ringedSquid/StuyOly_DB_2022/media/V2.jpg

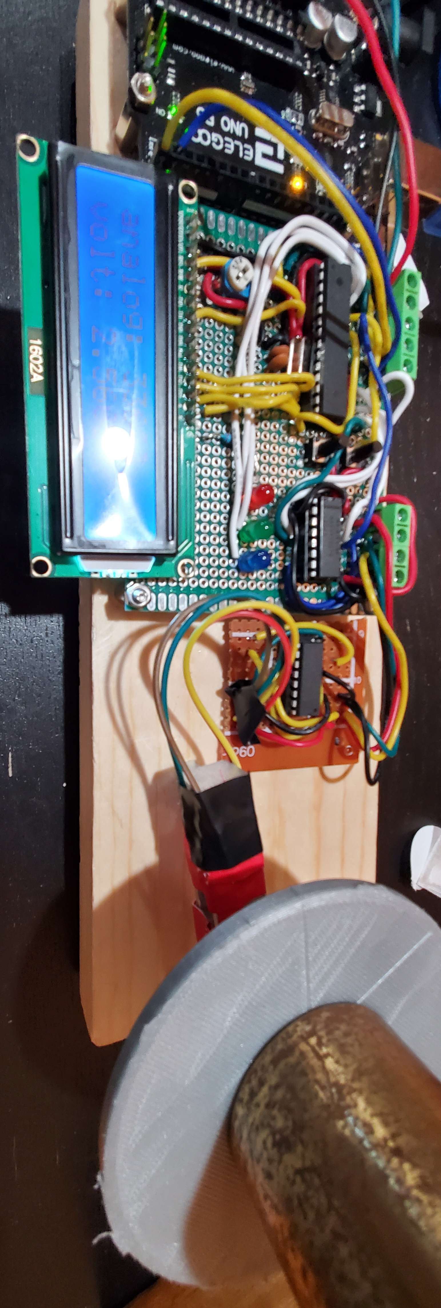
media/V2.jpg
