ringedSquid/StuyOly_DB_2022/media/V2_Gauge.jpg

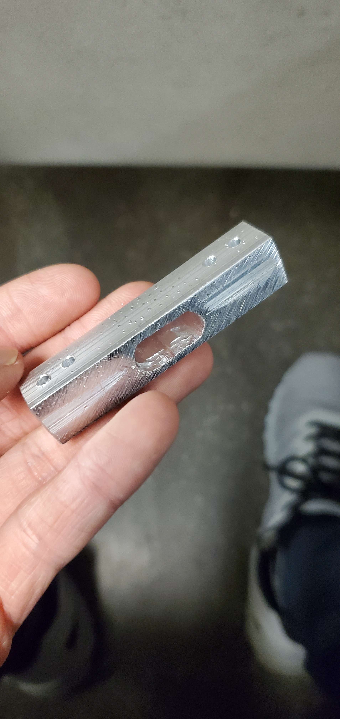
media/V2_Gauge.jpg
