ringedSquid/StuyOly_DB_2022/media/V3_0.jpg

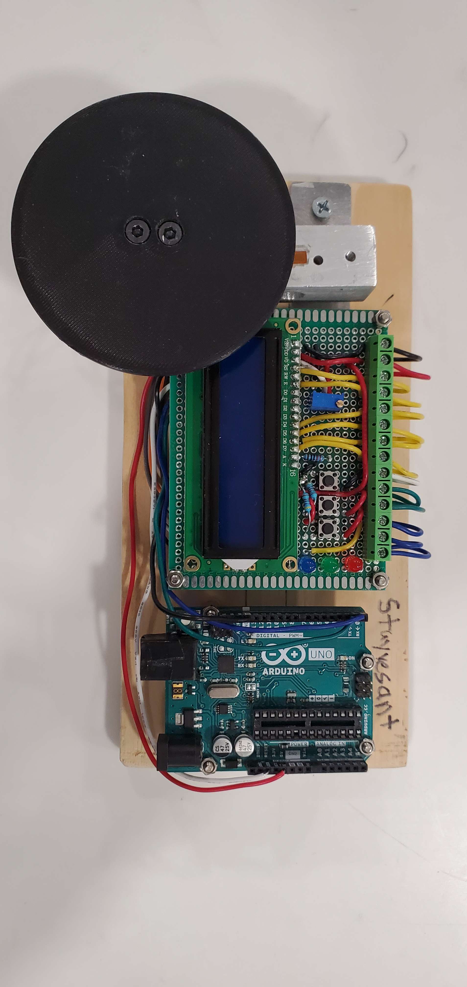
media/V3_0.jpg
