ringedSquid/StuyOly_DB_2022/media/V3_Gauge.jpg

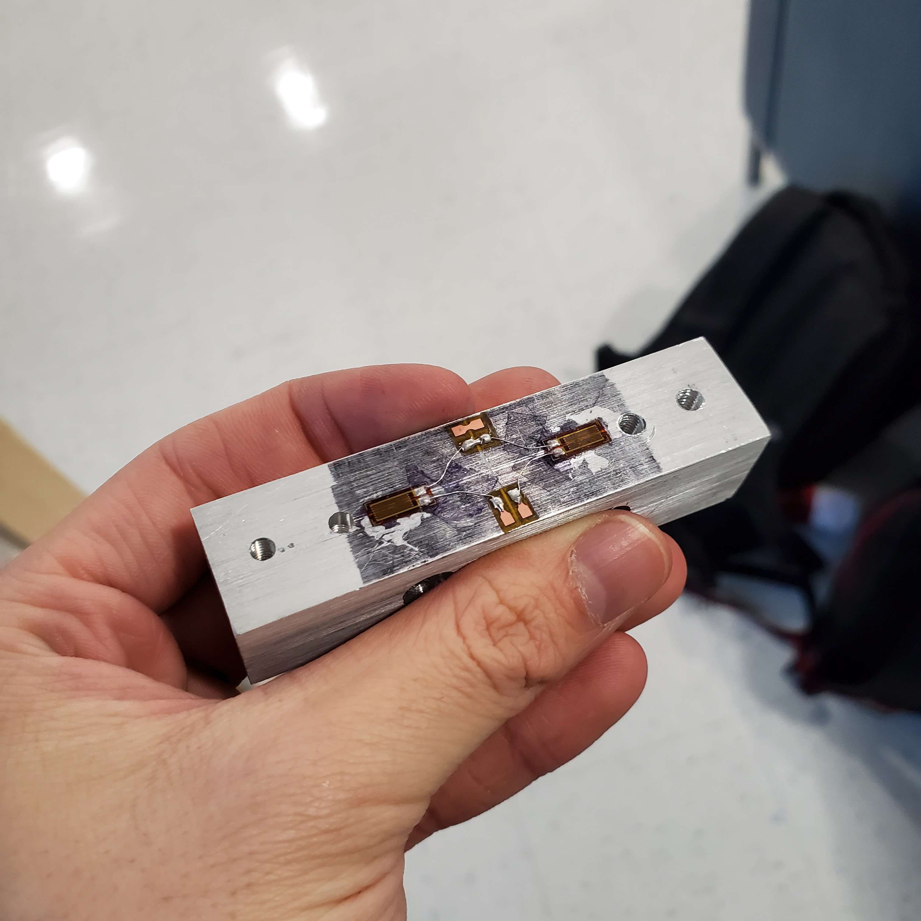
media/V3_Gauge.jpg
