ringedSquid/StuyOly_DB_2022/V1/V1_Design_Log.pdf

# Stuyvesant High School B Team #27

# Columbia Invitational 2023 Detector Building Design Log

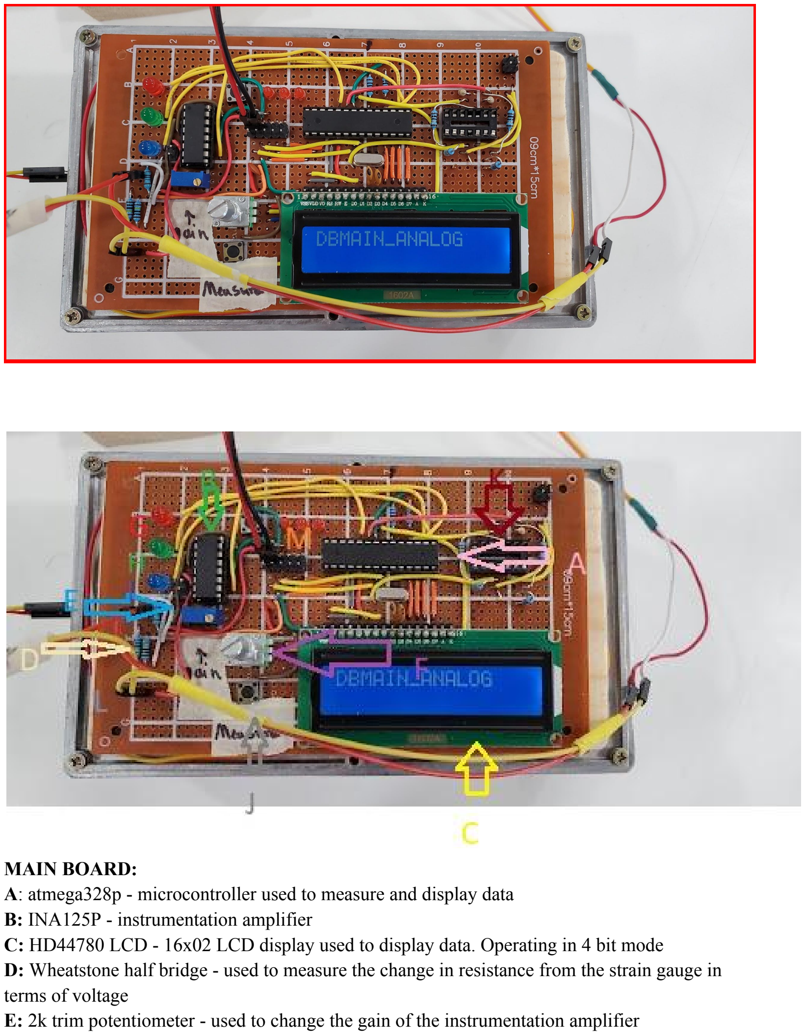
[picture p13: page 2]

### MAIN BOARD: A: atmega328p - microcontroller used to measure and display data B: INA125P - instrumentation amplifier C: HD44780 LCD - 16x02 LCD display used to display data. Operating in 4 bit mode

D: Wheatstone half bridge - used to measure the change in resistance from the strain gauge in

### terms of voltage E: 2k trim potentiometer - used to change the gain of the instrumentation amplifier

F: 10k potentiometer - changes the contrast of the LCD display G: Red LED H: Green LED I: Blue LED J:"Measure" button - signals microcontroller to read data from the sensor K: Socket for LM324 - amplifier used in early iterations of our design L: Connector for stressed strain gauge M: Connector for unstressed strain gauge

### The circuit was first prototyped on a breadboard, and then soldered to a 9x15cm

perfboard, which provided more consistent readings from the sensor. IC sockets are used to ensure that ics can be quickly replaced. Initially a LM324 quad op-amp was utilized to amplify

### the voltage from the wheatstone bridge, However we switched to using a INA125P

instrumentation amplifier to carry out this task. We decided to leave in the socket for the LM324 as an alternative amplifier if the INA125P were to fail during competitions.

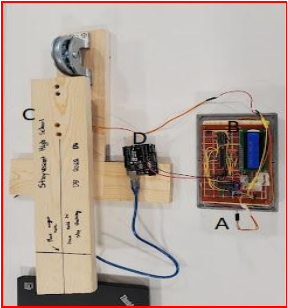
[picture p14: figure]

### ENTIRE SETUP:

### A: Housing for main board and unstressed strain gauge B: Main electronics board C: Force/mass sensor D: arduino board used to program and provide power to the whole device

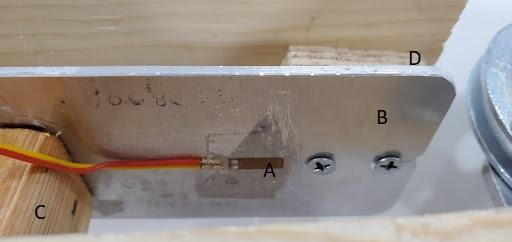
[picture p15: figure]

### FORCE/MASS SENSOR: A: Strain gauge B: 6062 Aluminum plate C: Measurement mechanism D: Counterweight

### A singular strain gauge was glued to a plate of 6061 aluminum to measure forces acted

upon it. Because of the relatively high rigidity of the aluminum, a lever mechanism is used to

### increase the amount of force acting on the aluminum. Because of the size of the lever, a

counterweight is needed in order to keep the sensor secured. Another strain gauge identical to the first was glued to the metal housing and no force would be acted upon it. Due to the fact that the resistance of strain gauges can vary with temperature, in order to produce consistent results, 2 strain gauges are used to counteract temperature fluctuations.

Mass (g) | Digital | Analog | Digital1 | Analog1 | Digital avg | Analog avg
20 | 3.87 | 0.02 | 2.31 | 0.01 | 3.09 | 0.015
30 | 4.12 | 0.02 | 4.24 | 0.02 | 4.18 | 0.02
40 | 7.22 | 0.04 | 6.51 | 0.03 | 6.865 | 0.035
50 | 8.39 | 0.04 | 9.67 | 0.05 | 9.03 | 0.045
60 | 10.69 | 0.05 | 12.2 | 0.06 | 11.445 | 0.055
70 | 12.08 | 0.06 | 14.48 | 0.07 | 13.28 | 0.065
80 | 15.7 | 0.08 | 15.39 | 0.08 | 15.545 | 0.08
90 | 17.94 | 0.09 | 17.82 | 0.09 | 17.88 | 0.09
100 | 19.74 | 0.1 | 19.55 | 0.1 | 19.645 | 0.1
110 | 22.42 | 0.11 | 22.17 | 0.11 | 22.295 | 0.11
120 | 23.43 | 0.11 | 23.96 | 0.12 | 23.695 | 0.115
130 | 26.03 | 0.13 | 26.16 | 0.13 | 26.095 | 0.13
140 | 26.22 | 0.13 | 27.69 | 0.14 | 26.955 | 0.135
150 | 30.33 | 0.15 | 30.11 | 0.15 | 30.22 | 0.15
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

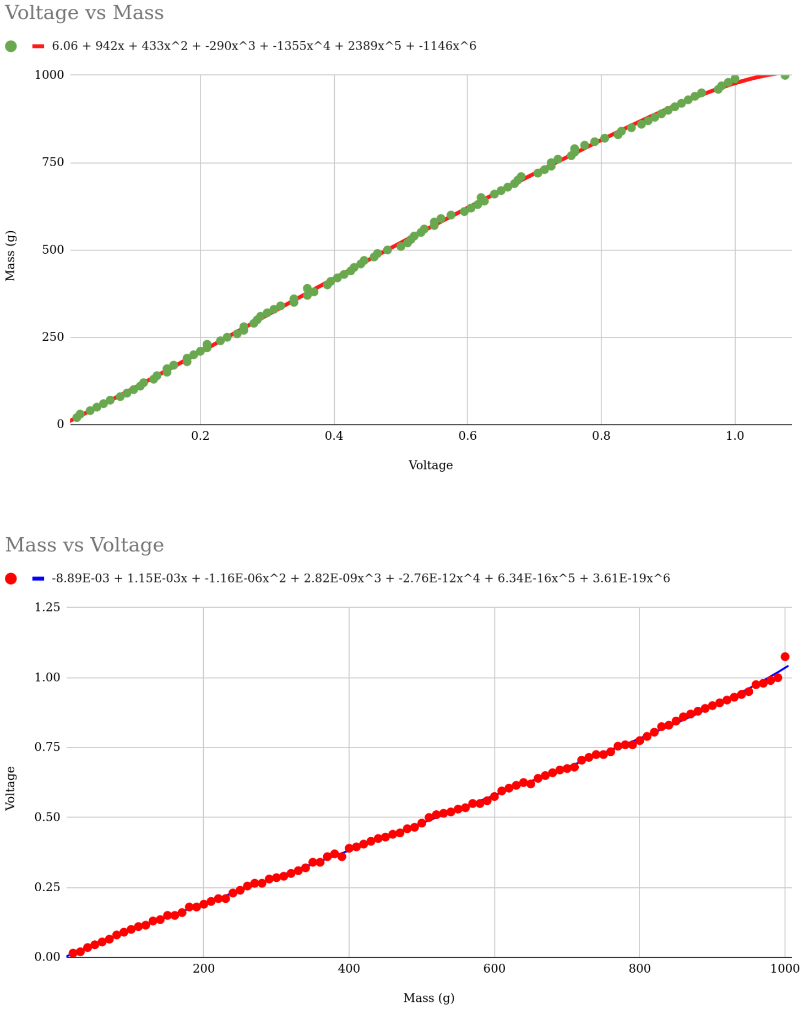
[picture p16: page 8]
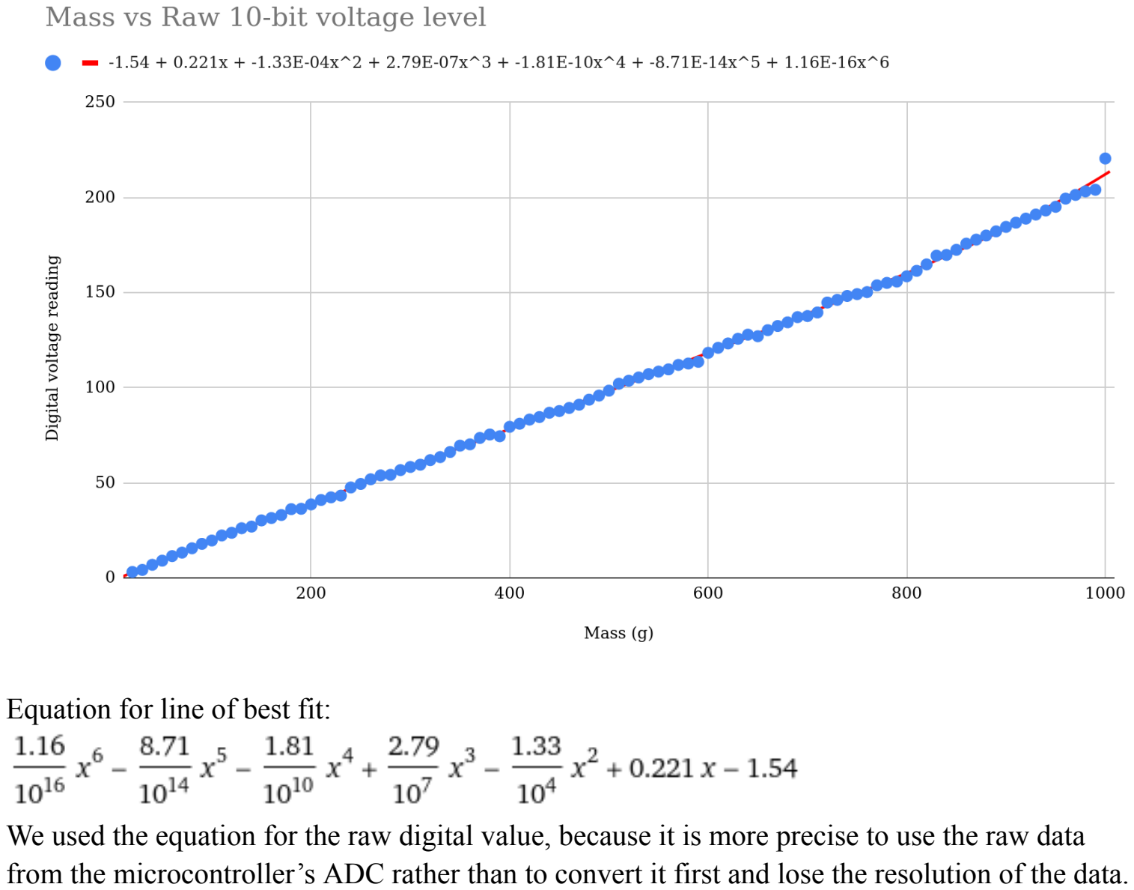
[picture p17: page 9]

### Equation for line of best fit:

We used the equation for the raw digital value, because it is more precise to use the raw data from the microcontroller’s ADC rather than to convert it first and lose the resolution of the data.

### Code that runs on the microcontroller:

/*DBCornell2022*/
#include <LiquidCrystal.h>

#define READPIN A1

const int RS=2, E=3, D4=5, D5=6, D6=7, D7=8; //LCD Pins const int RED=11, GRN=10, BLU=9; //LED Pins
const int TOGGLE = 12;
/*Weight ranges in GRAMS, R1 <= R2*/
const double R1 = 67;
const double R2 = 705;
double offset = 0; //offset reading for sensor
const int TESTS = 5000;
const int INIT_TESTS = 1000;
; //amount of times for the microcontroller to measure data from the sensor. Its all averaged out

LiquidCrystal lcd(RS, E, D4, D5, D6, D7);

void setup() {
double init_avg = 0;
pinMode(RED, OUTPUT);
pinMode(GRN, OUTPUT);
pinMode(BLU, OUTPUT);
digitalWrite(RED, LOW);
digitalWrite(GRN, LOW);
digitalWrite(BLU, LOW);
pinMode(TOGGLE, INPUT);
lcd.begin(16, 12);
lcd.setCursor(0, 0);
lcd.print("INIT...");
delay(1000);
for (int i=0; i<INIT_TESTS; i++) { init_avg += analogRead(READPIN); }
offset = init_avg/INIT_TESTS; lcd.clear();
lcd.setCursor(0, 0);
lcd.print("DBMAIN_CORN");
}

double gx(double x);
double gx1(double x);
double newtonsmethod(double k);

void loop() {
double finalsum = 0;
double mass = 0;
boolean interrupt = false; //button pressed? while (interrupt == false) {
if (digitalRead(TOGGLE) == HIGH) { lcd.clear();
lcd.setCursor(0, 0);
lcd.print("Measuring..."); lcd.setCursor(0, 1);
delay(1000);
for (int i=0; i<TESTS; i++) {
finalsum += analogRead(READPIN) - offset; }
finalsum /= TESTS;
mass = newtonsmethod(finalsum); lcd.clear();
lcd.setCursor(0, 0);
lcd.print(finalsum*(5/1023.0)); lcd.print("v");
lcd.setCursor(0, 1);
lcd.print(mass);
lcd.print("g");
if (mass < R1) {
digitalWrite(RED, HIGH);
digitalWrite(GRN, LOW);
digitalWrite(BLU, LOW);
}
else if ((mass > R1) && (mass < R2)) { digitalWrite(RED, LOW);
digitalWrite(GRN, HIGH);
digitalWrite(BLU, LOW);
}
else {
digitalWrite(RED, LOW);
digitalWrite(GRN, LOW);
digitalWrite(BLU, HIGH);
}
interrupt = true;
}
}
}

double gx(double x) { //g(x)
return (1.16*pow(10, -16)*pow(x, 6)) - (8.71*pow(10,-14)*pow(x,5))-(1.81*pow(10,-10)*pow(x,4)) + (2.79*pow(10,-7)*pow(x,3))-(0.000133*pow(x,2))+(0.221*x)-1.54;
}

double gx1(double x) { //Derivative of g(x)
return (6.96*pow(10, -16)*pow(x , 5)) -(4.355*pow(10, -13)*pow(x , 4)) - (7.24*pow(10, -10)*pow(x,3))+(8.37*pow(10,-7)*pow(x , 2)) - (0.000266*x) + 0.221;
}
double newtonsmethod(double k) {
double x = 100;
for(int i=0; i<30; i++) {
x = ((gx1(x)*x)-(gx(x)-k))/gx1(x); }
return x;
}

### How we get a mass from voltage:

In order to find the mass of a sample based on the voltage read from the sensor, we must solve for x in our mathematical model. However, solving for a polynomial of degree 6 is quite difficult and so we approximate our x value using Newton's method.
