ringedSquid/StuyOly_DB_2022/STUY_OLY_DB_2023_DATA.pdf

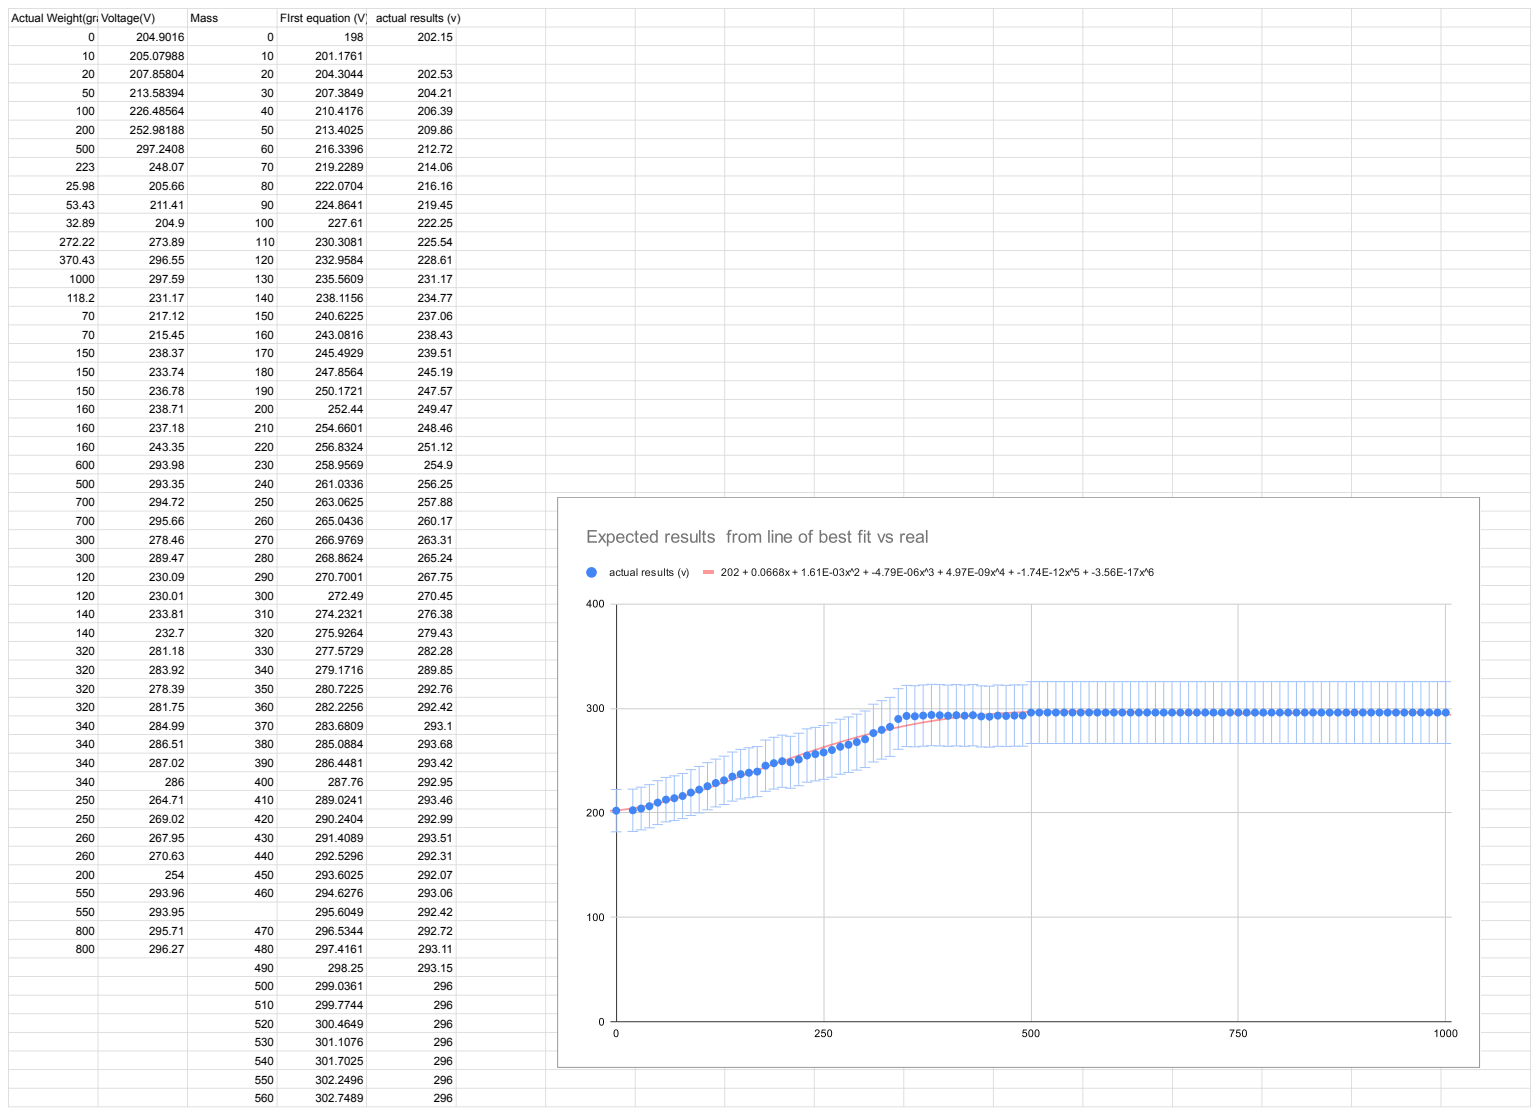
[picture p23: page 1]
Actual Weight(grams) Voltage(V); Mass; FIrst equation (V) actual results (v)

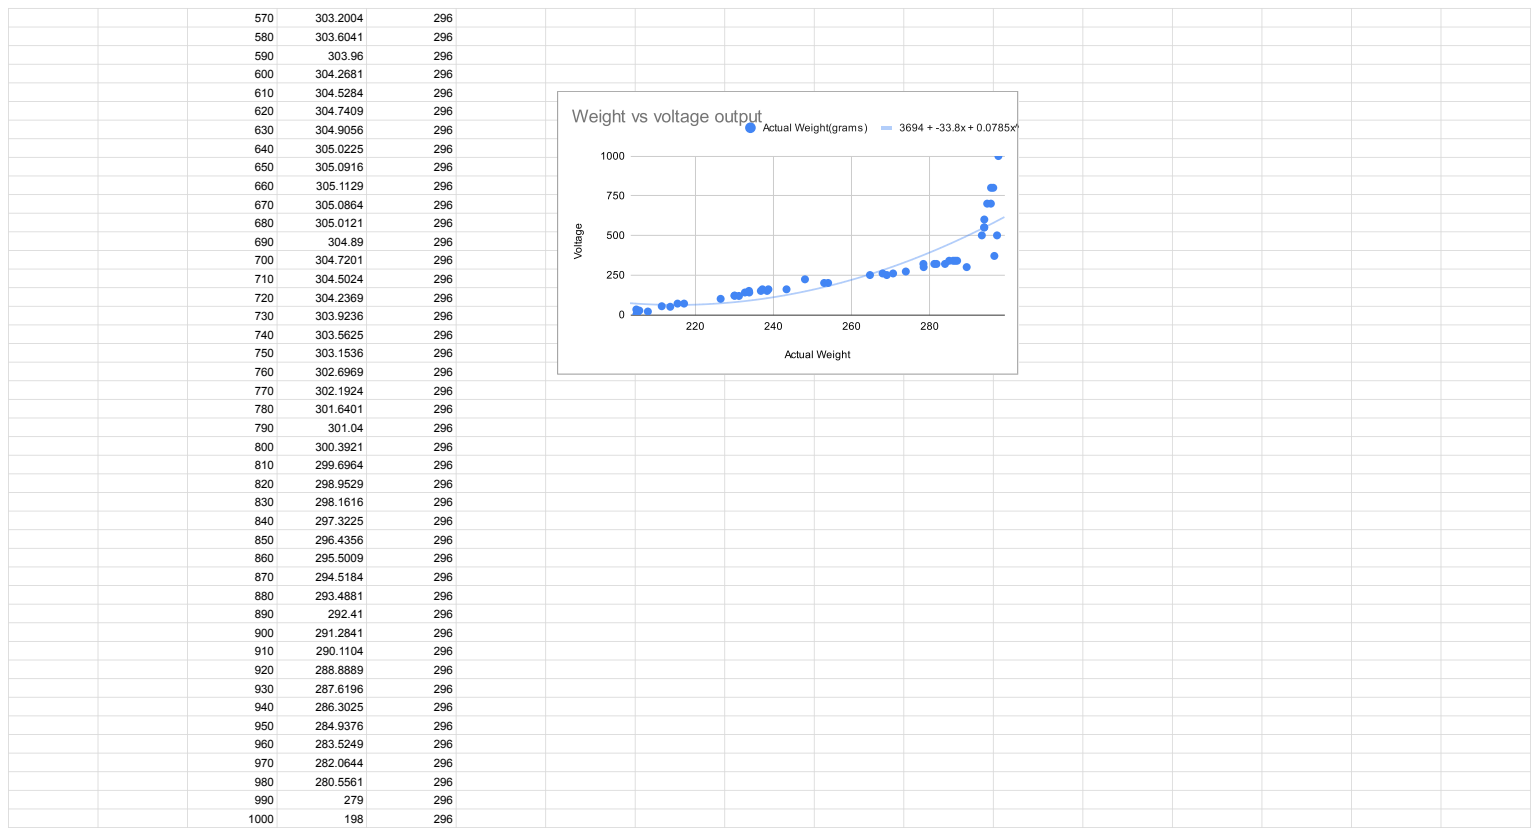
[picture p24: page 2]

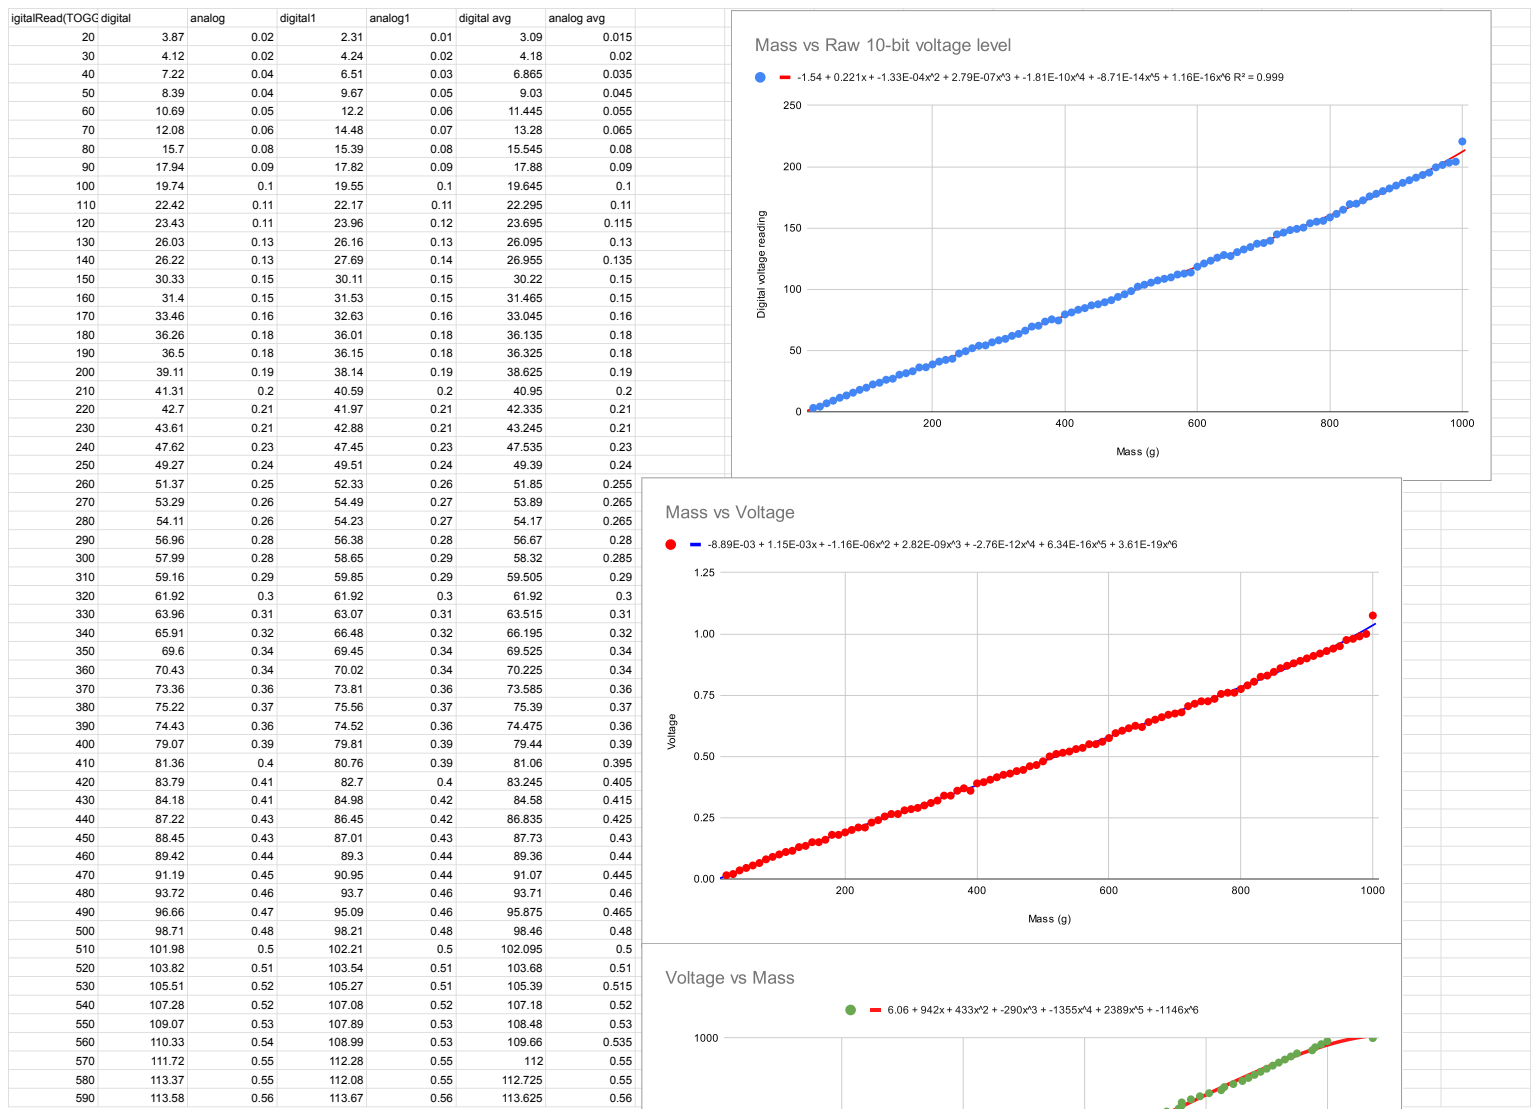
[picture p25: page 3]
igitalRead(TOGGLE) == HIGH digital; analog; digital1; analog1; digital avg; analog avg; mass

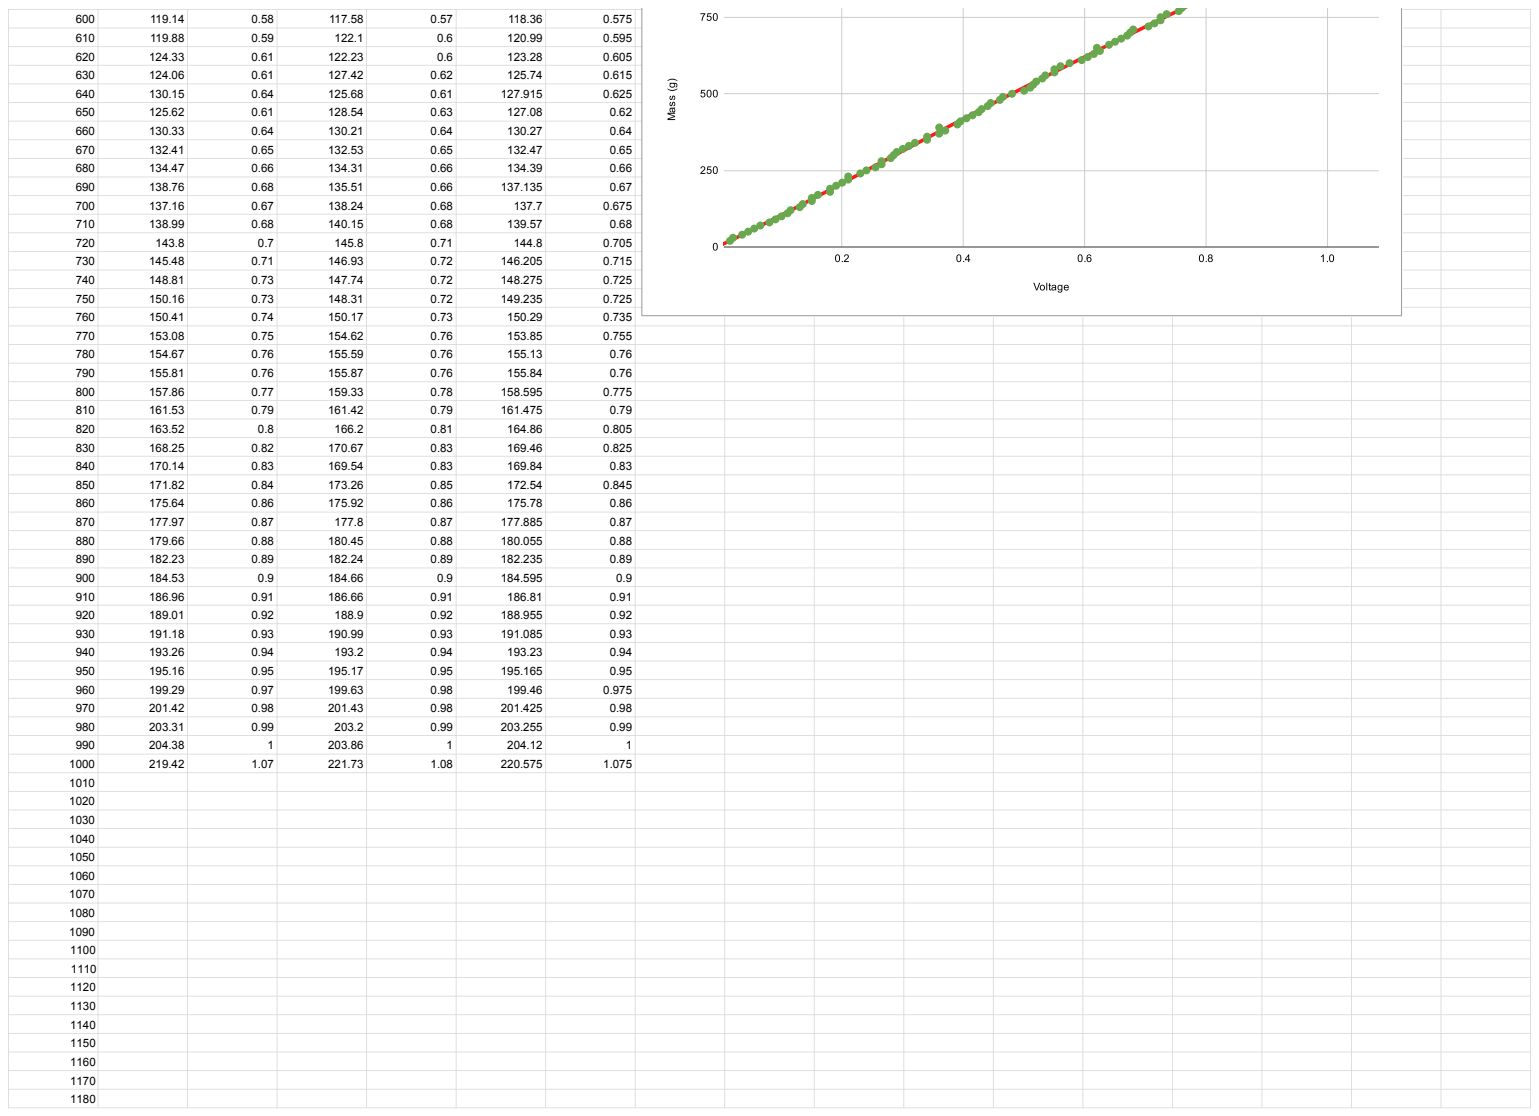
[picture p26: page 4]

# digital reading

0 | 223.5

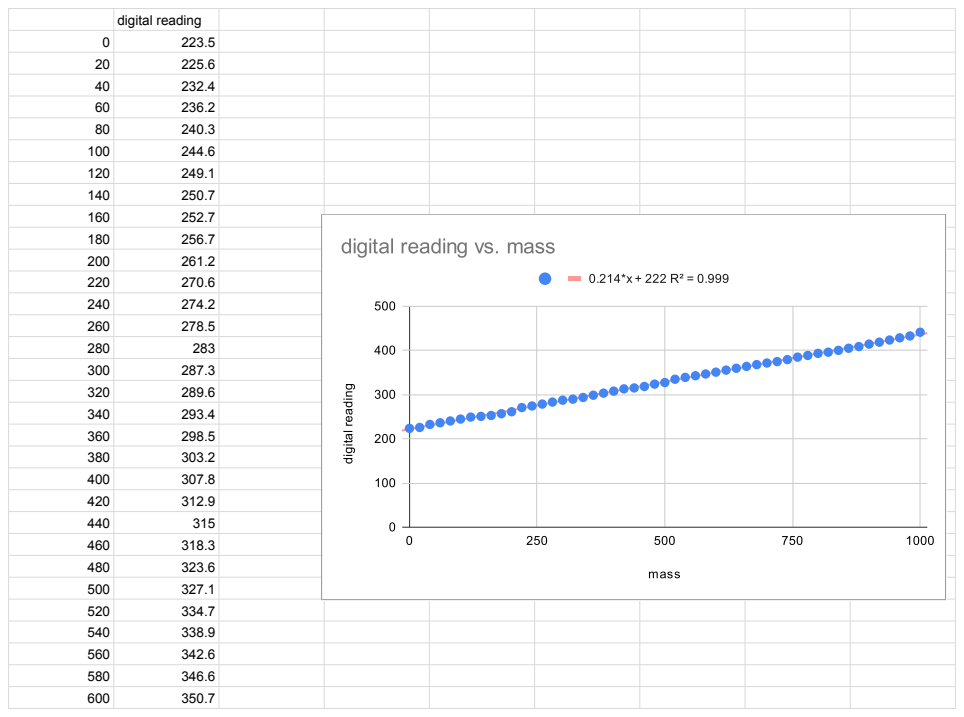
[picture p27: page 6]

620 | 355.3
640 | 359.5

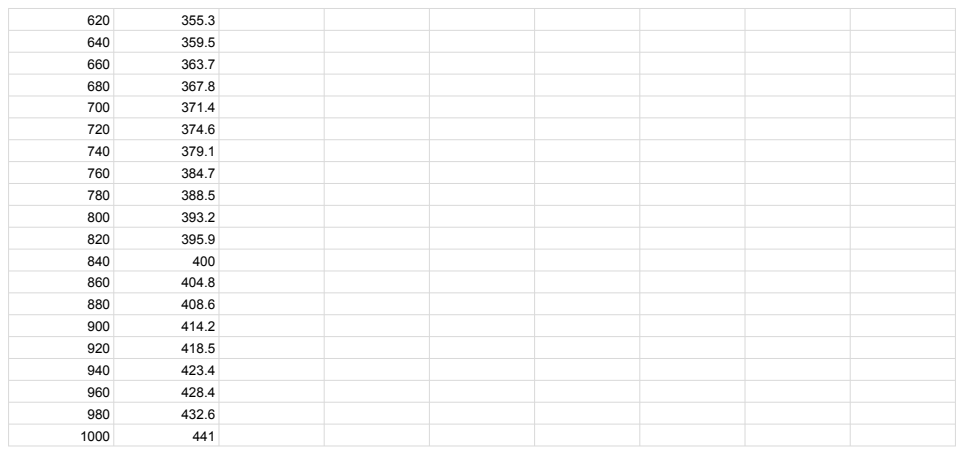
[picture p28: page 7]

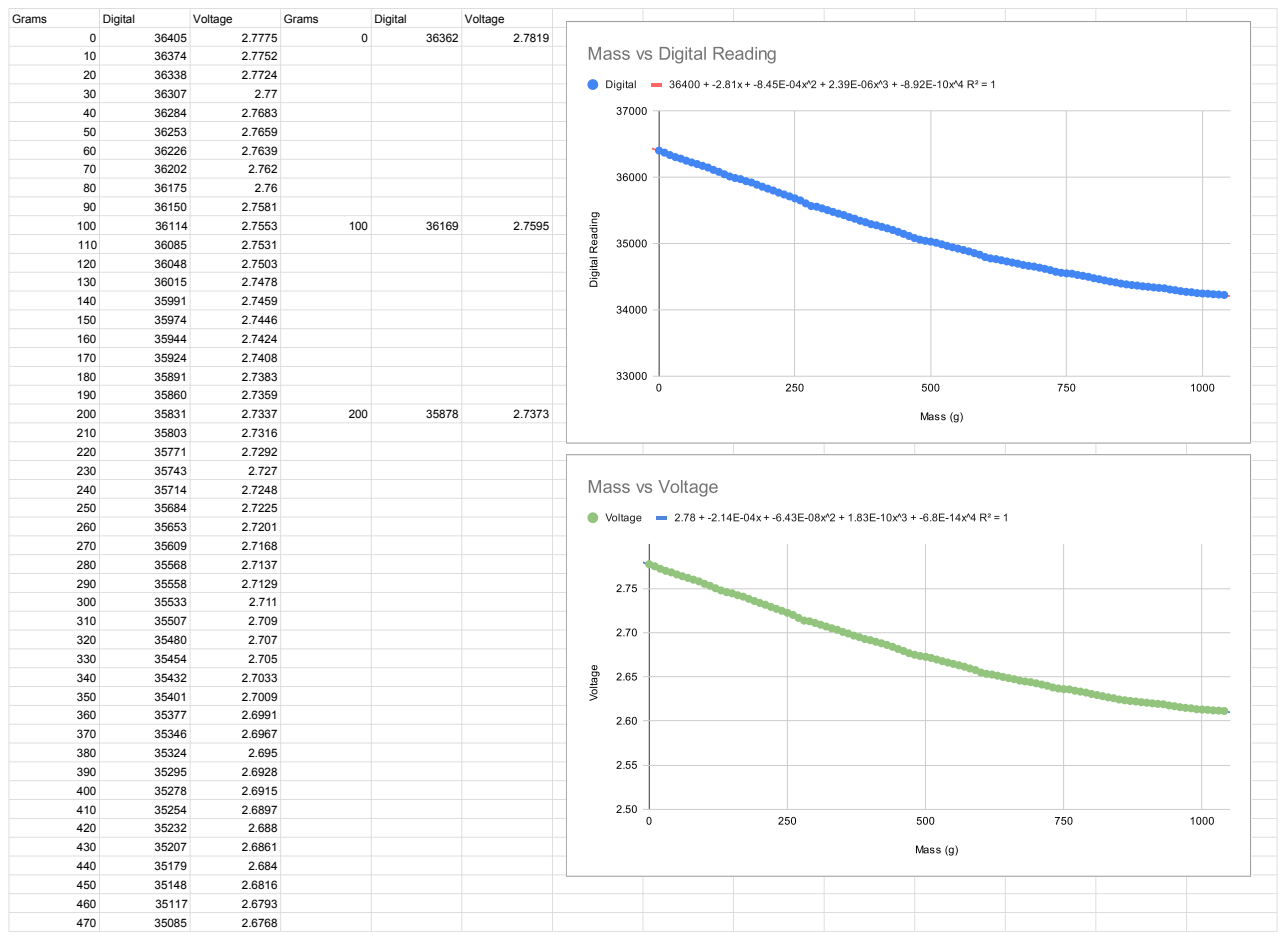
[picture p29: page 8]
Grams; Digital; Voltage

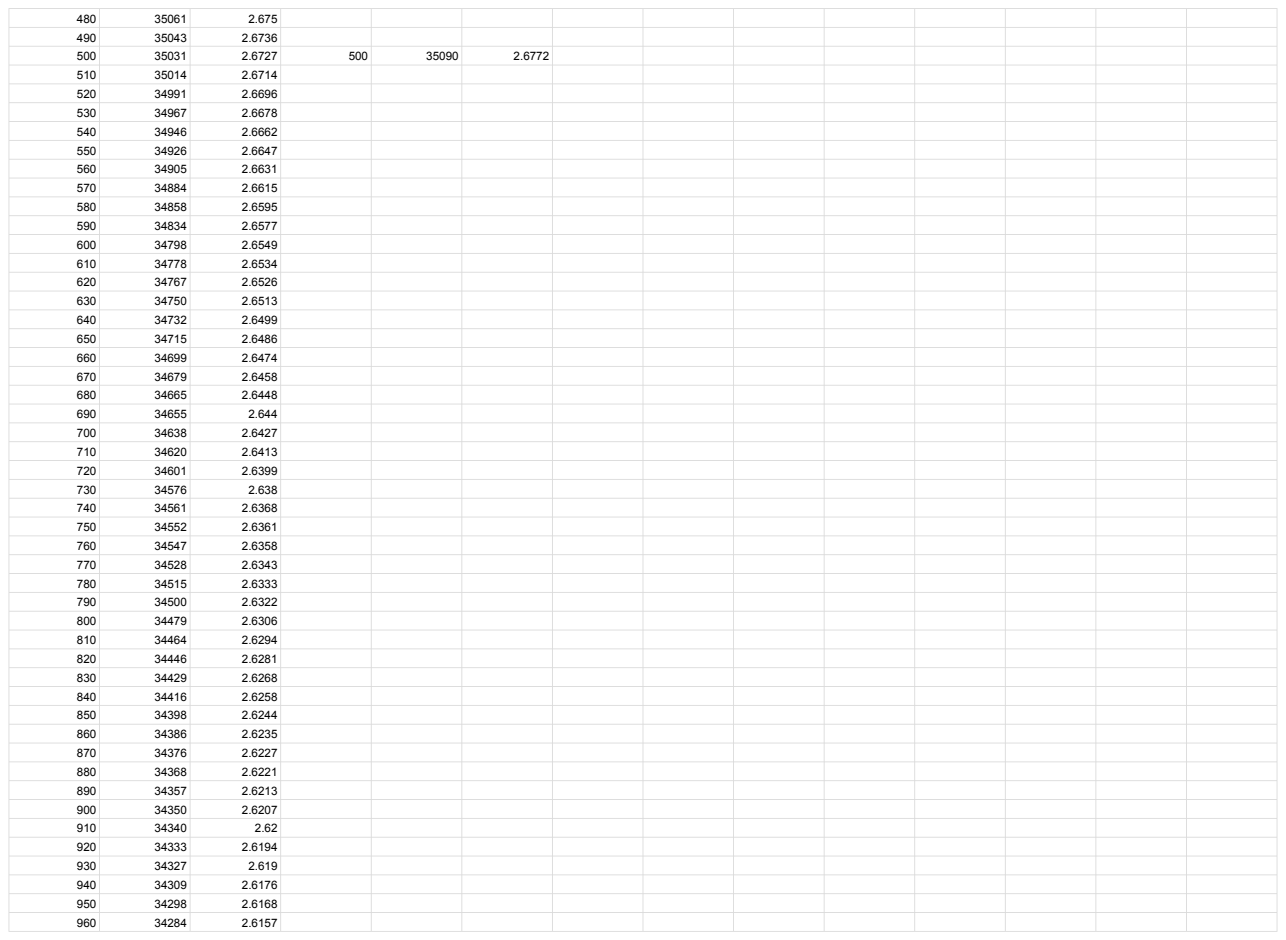
[picture p30: page 9]

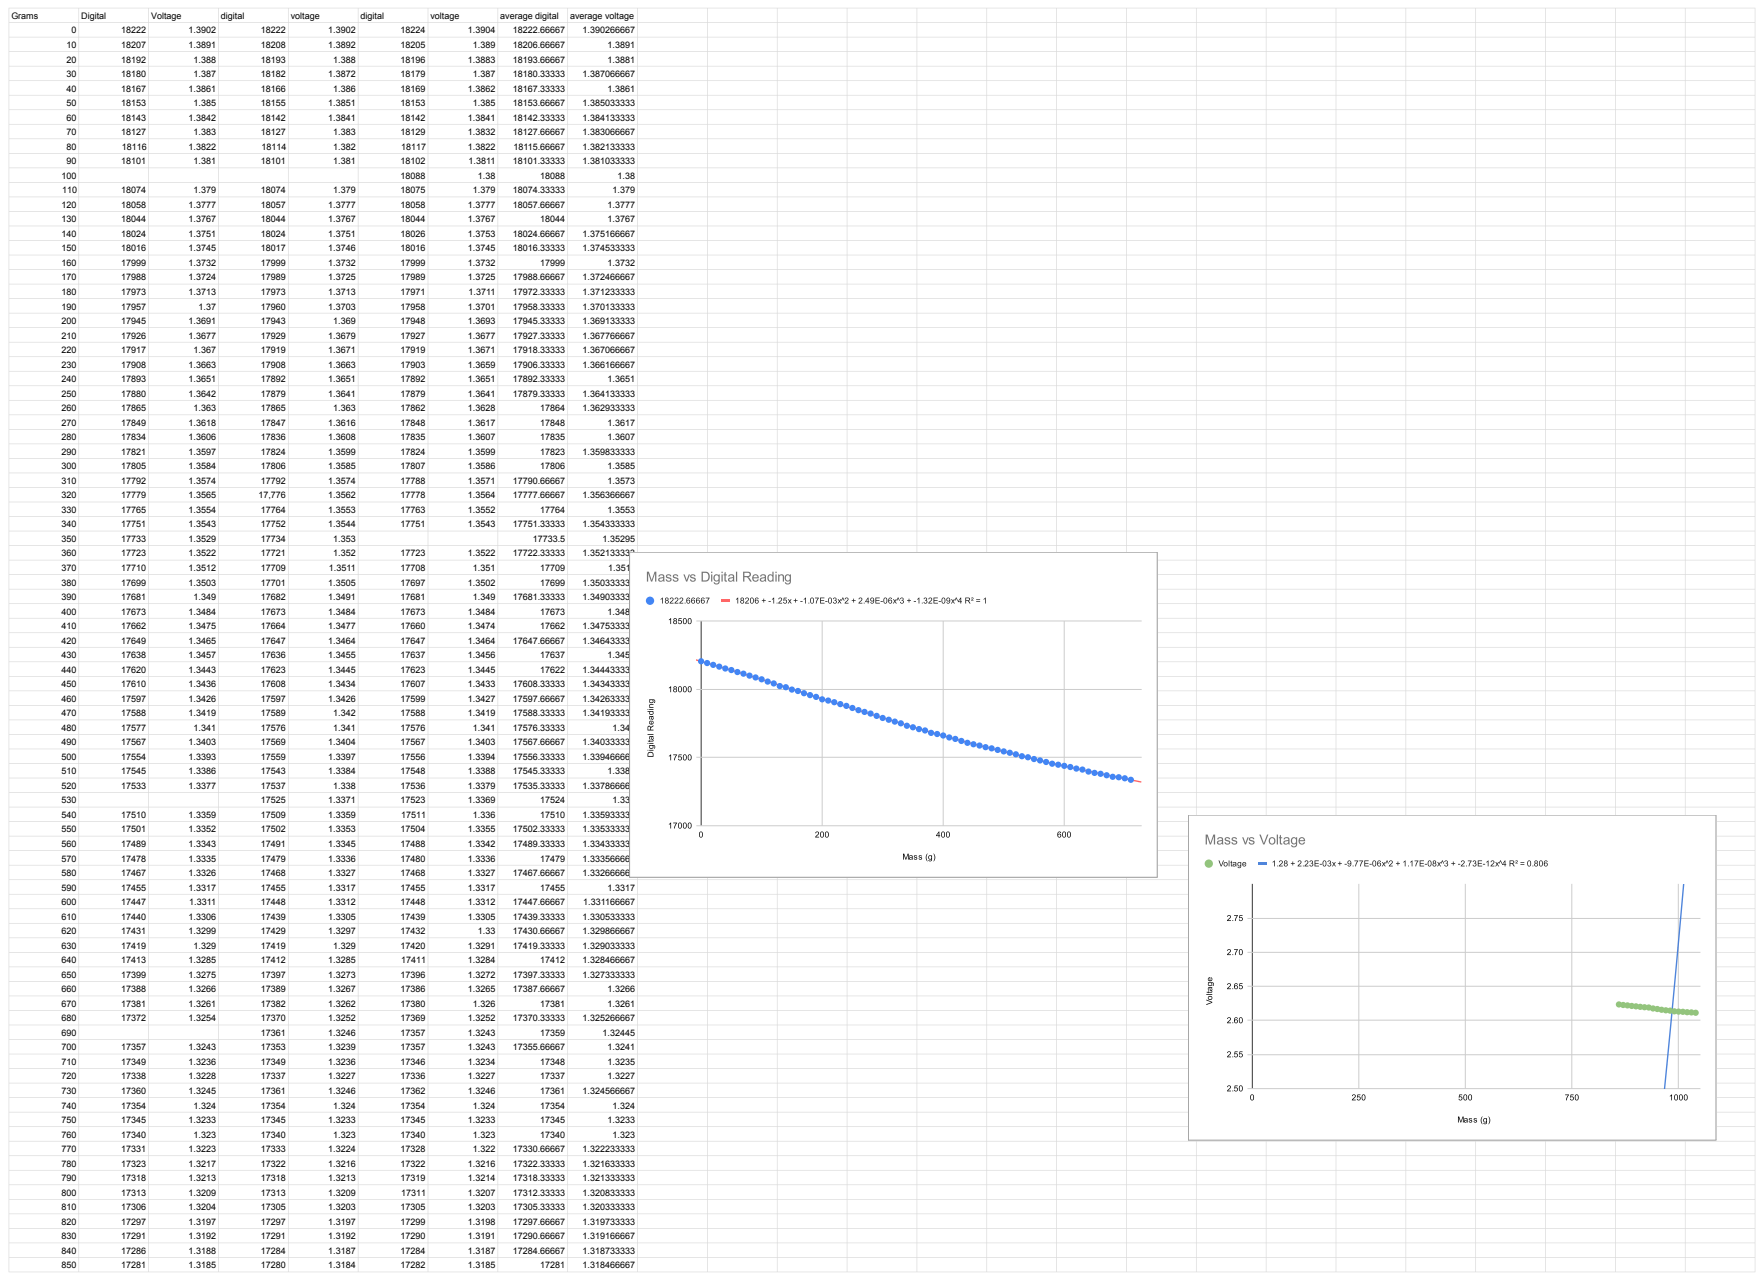
[picture p31: page 11]
Grams; Digital; Voltage; digital; voltage; average digital; average voltage

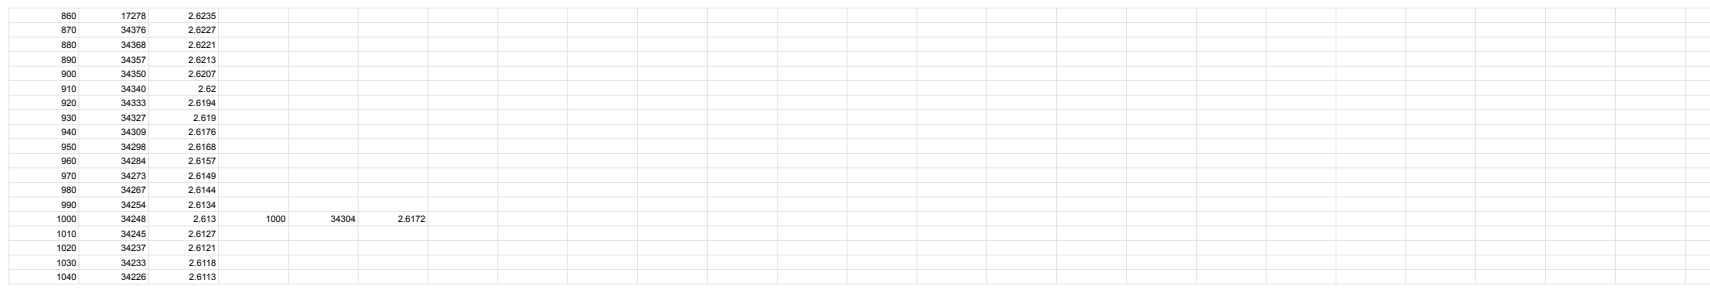
[picture p32: page 12]

mass in grams | digital | voltage
0 | 34361 | 2.6216

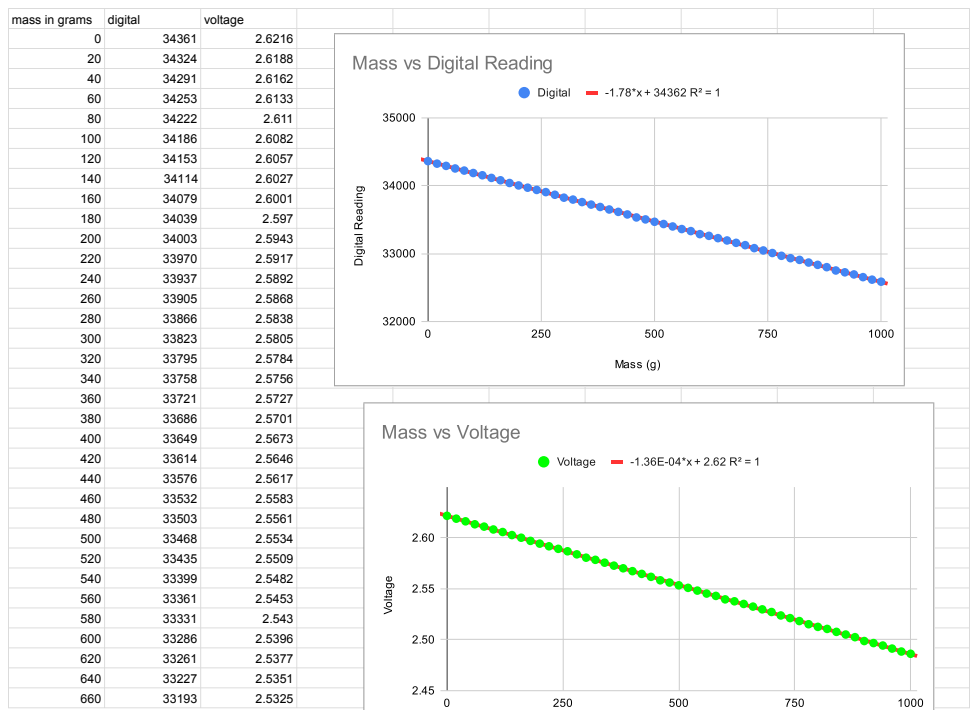
[picture p33: page 13]

680 | 33158 | 2.5298
700 | 33124 | 2.5272

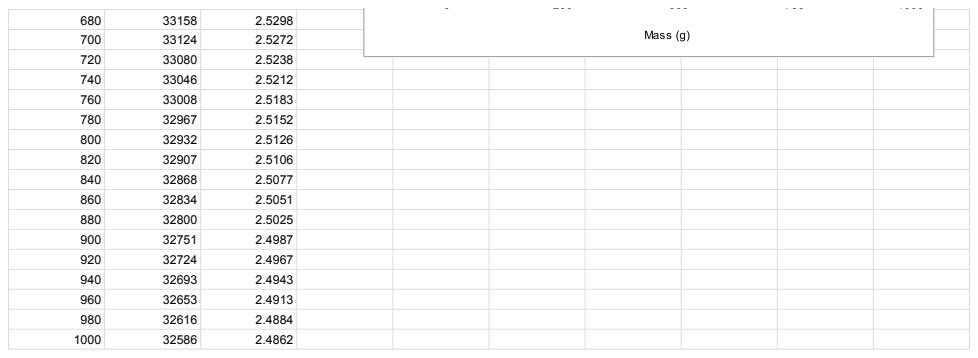
[picture p34: page 14]

mass in grams | digital | voltage
0 | 34310 | 2.6177

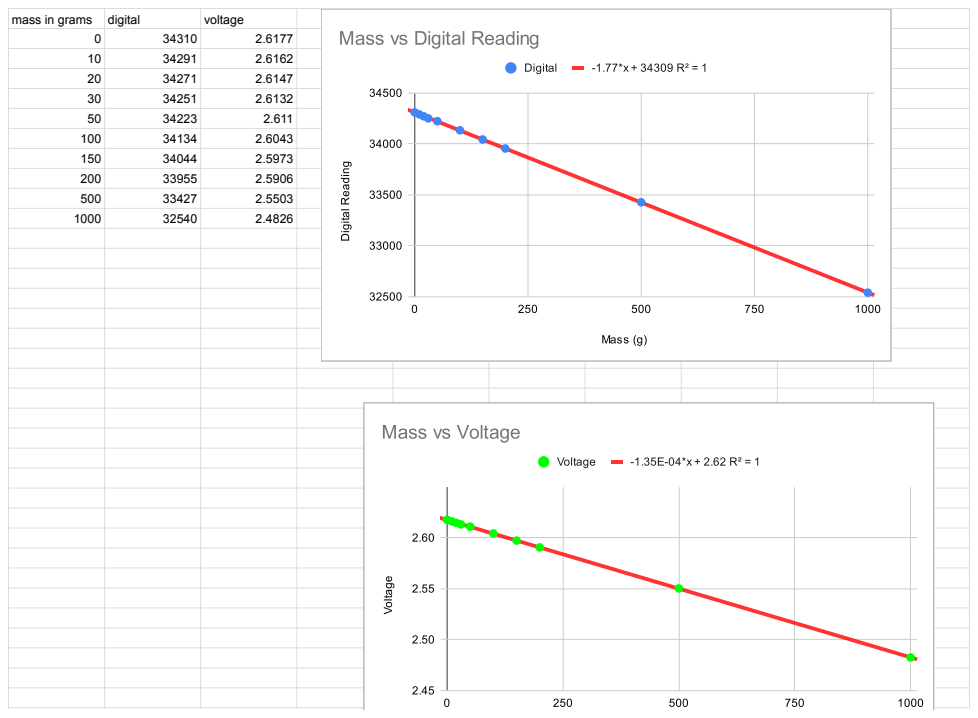
[picture p35: page 15]

Mass G | Digital1 | Digital2
0 | 334526 | 335328

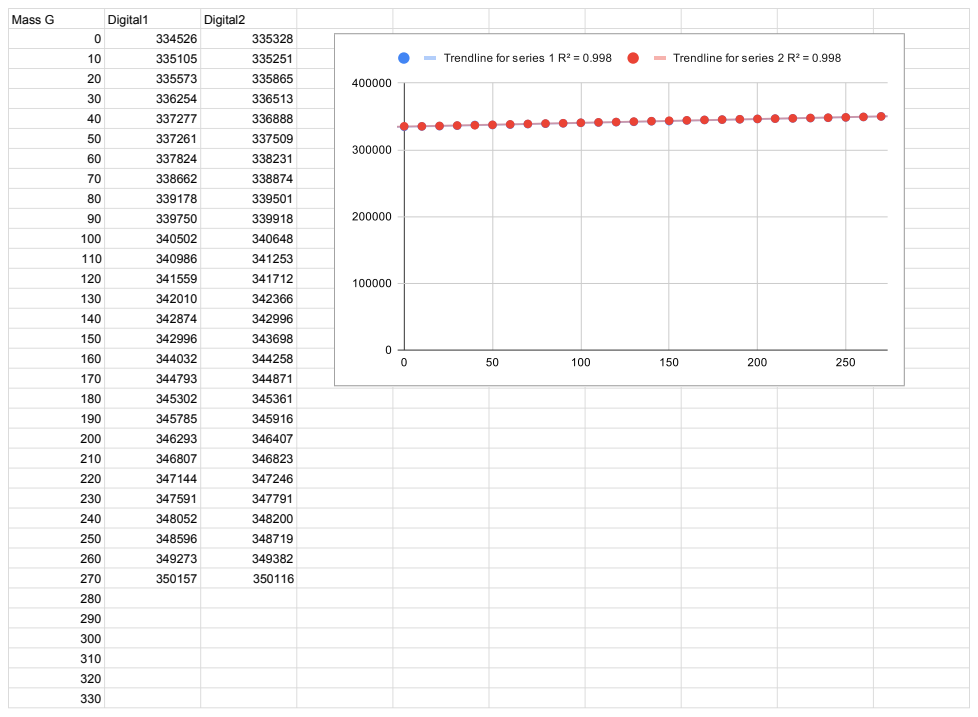
[picture p36: page 17]

340
350

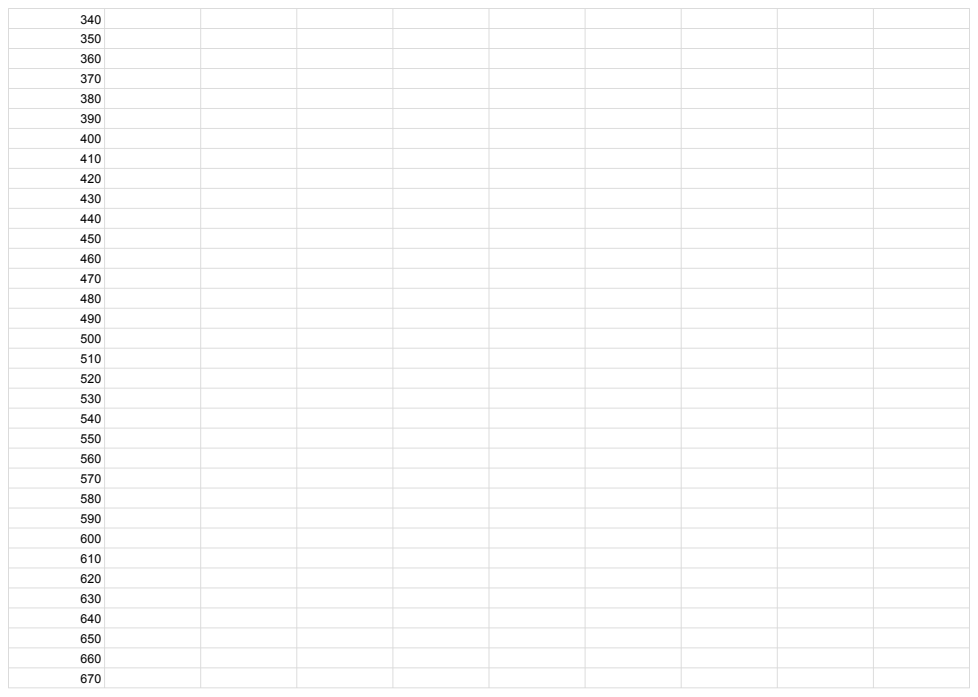
[picture p37: page 18]

680
690

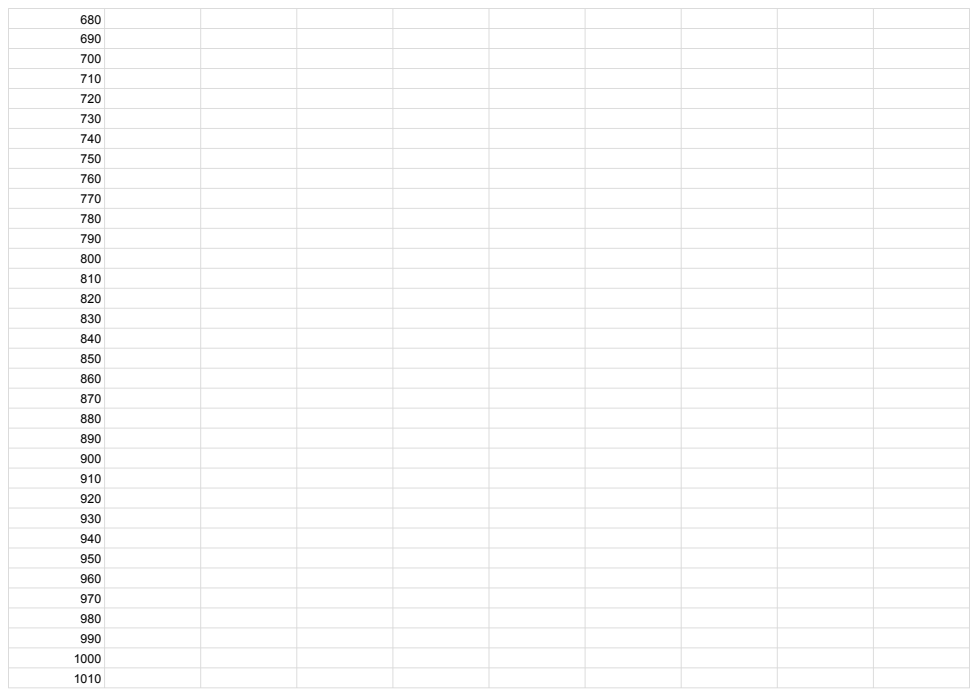
[picture p38: page 19]

1020
1030
1040
1050
1060
1070
1080

Mass (g) | Digital Read | Digital Read2
0 | 88204 | 87443

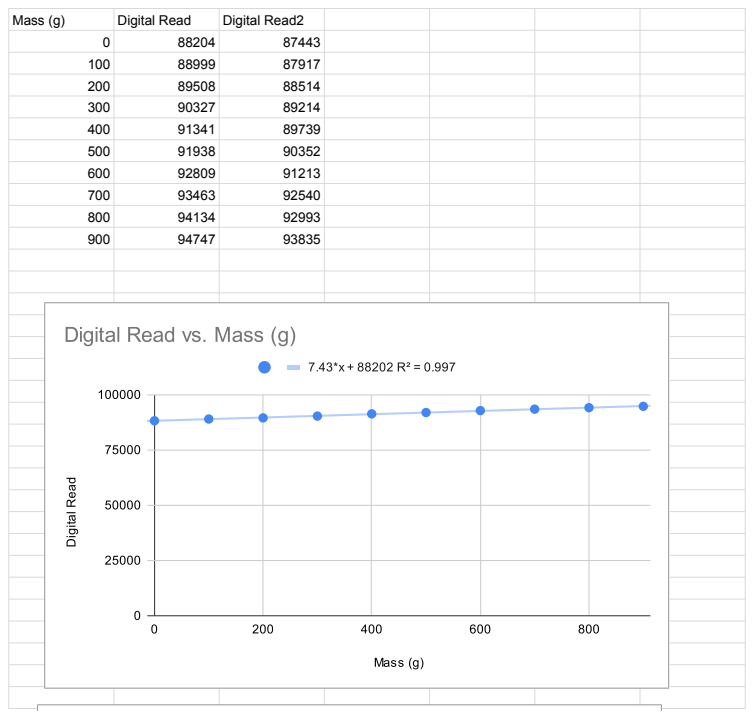
[picture p39: page 21]

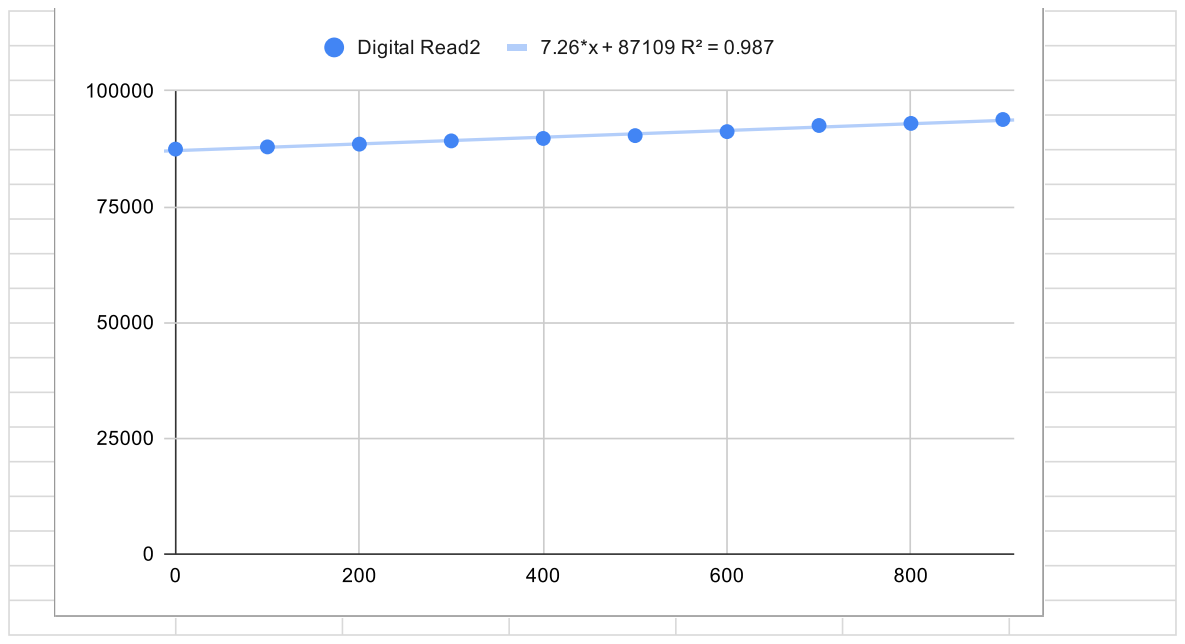
[picture p40: page 22]
