ringedSquid/StuyOly_DB_2022/(commit log)

2022-11-13 sensor broke, but stuff is working, ready for recalibration and data test
2023-01-06 ADC Works!
